Bluelavasystems/xt-ide/README.md

 Slot 8 Support

If you want to use this card with an IBM 5160 PC/XT in Slot 8, you need a small daughterboard to make this happen.

Based on Glitch Works, LLC XT-IDE rev 4: https://github.com/glitchwrks/xt_ide
